nigel-daniels/ADSR-1/LM336-5.0/LM336-5.0.step

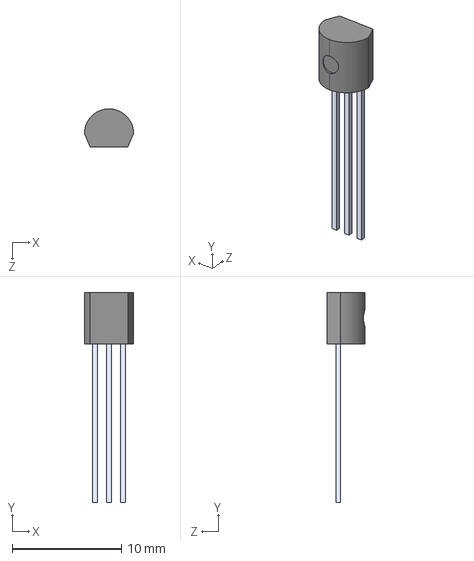
[picture p2: CAD file, 2026-11-09]
LM336-5.0/LM336-5.0.step
4.50 x 19.2 x 3.50 mm
