nigel-daniels/ADSR-1/ADSR 1.kicad_pcb

## KiCad design ADSR 1.kicad_pcb (2026-11-09)

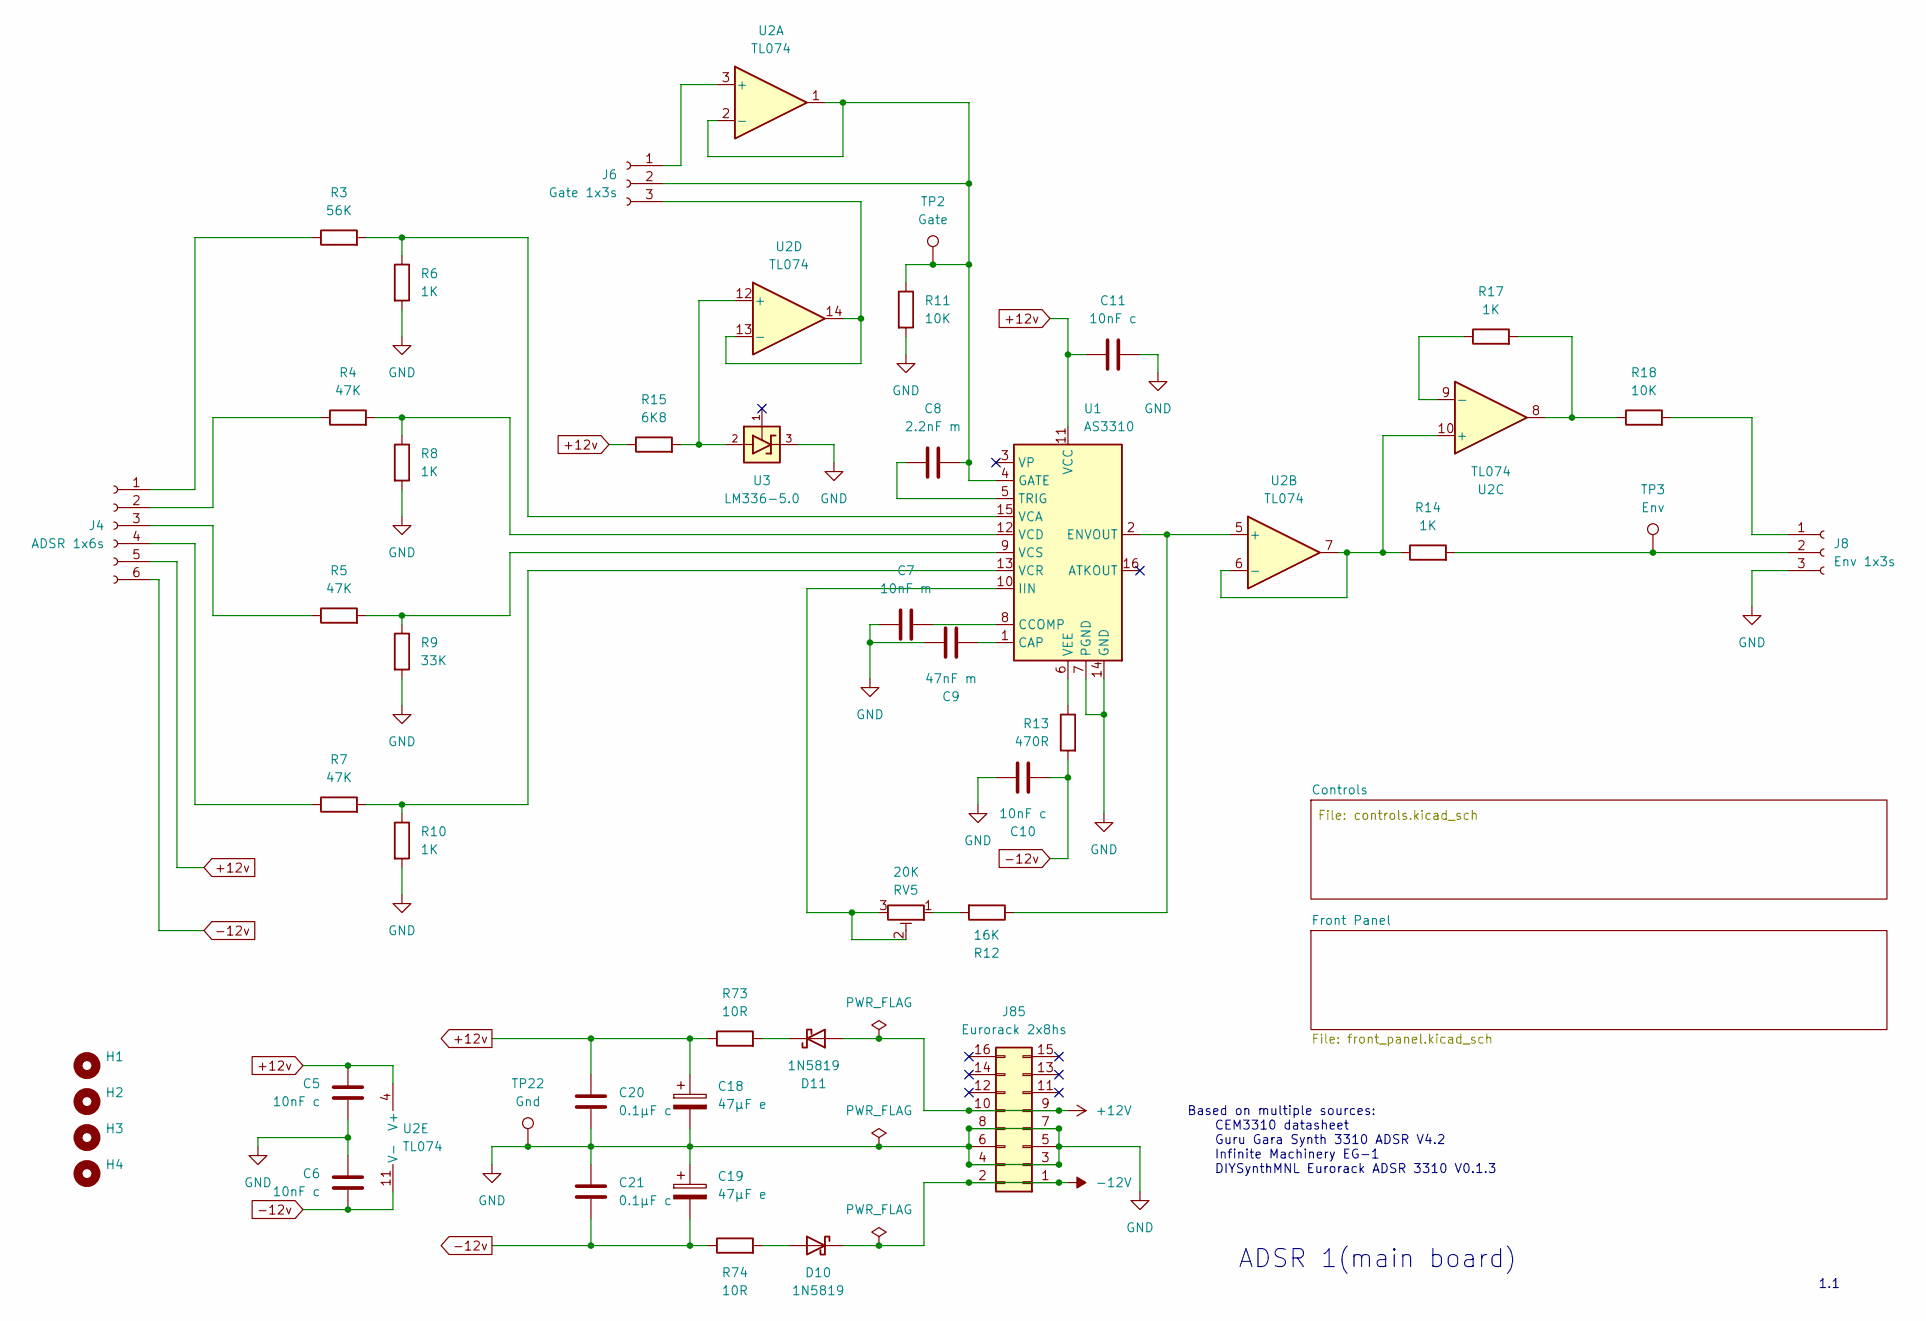
[picture p3: schematic ADSR 1.kicad_sch]

Parts:
C5, C6, C10, C11: 10nF c; C_Disc_D4.7mm_W2.5mm_P5.00mm
C7: 10nF m; C_Rect_L7.2mm_W2.5mm_P5.00mm
C8: 2.2nF m; C_Rect_L7.2mm_W2.5mm_P5.00mm
C9: 47nF m; C_Rect_L7.2mm_W2.5mm_P5.00mm
C18, C19: 47μF e; CP_Radial_D5.0mm_P2.50mm
C20, C21: 0.1μF c; C_Disc_D4.7mm_W2.5mm_P5.00mm
D10, D11: 1N5819; D_DO-41_SOD81_P10.16mm_Horizontal
H1, H2, H3, H4: MountingHole_2.7mm_M2.5
J4: ADSR 1x6s; PinSocket_1x06_P2.54mm_Vertical
J6: Gate 1x3s; PinSocket_1x03_P2.54mm_Vertical
J8: Env 1x3s; PinSocket_1x03_P2.54mm_Vertical
J85: Eurorack 2x8hs; IDC-Header_2x08_P2.54mm_Vertical
R3: 56K; R_Axial_DIN0204_L3.6mm_D1.6mm_P2.54mm_Vertical
R4, R5: 47K; R_Axial_DIN0204_L3.6mm_D1.6mm_P2.54mm_Vertical
R6, R8, R10, R17: 1K; R_Axial_DIN0204_L3.6mm_D1.6mm_P2.54mm_Vertical
R7: 47K; R_Axial_DIN0204_L3.6mm_D1.6mm_P7.62mm_Horizontal
R9: 33K; R_Axial_DIN0204_L3.6mm_D1.6mm_P2.54mm_Vertical
R11, R18: 10K; R_Axial_DIN0204_L3.6mm_D1.6mm_P7.62mm_Horizontal
R12: 16K; R_Axial_DIN0204_L3.6mm_D1.6mm_P7.62mm_Horizontal
R13: 470R; R_Axial_DIN0204_L3.6mm_D1.6mm_P7.62mm_Horizontal
R14: 1K; R_Axial_DIN0204_L3.6mm_D1.6mm_P7.62mm_Horizontal
R15: 6K8; R_Axial_DIN0204_L3.6mm_D1.6mm_P7.62mm_Horizontal
R73, R74: 10R; R_Axial_DIN0204_L3.6mm_D1.6mm_P2.54mm_Vertical
RV5: 20K; Potentiometer_Bourns_3296X_Horizontal
TP2: Gate; TestPoint_Loop_D2.50mm_Drill1.0mm
TP3: Env; TestPoint_Loop_D2.50mm_Drill1.0mm
TP22: Gnd; TestPoint_Loop_D2.50mm_Drill1.0mm
U1: AS3310; DIP-16_W7.62mm_Socket
U2: TL074; DIP-14_W7.62mm_Socket
U3: LM336-5.0; TO-92_Inline_Wide

Connections:
+12V: D11.2 (A), J85.9, J85.10
+12v: C5.2, C11.1, C18.1, C20.1, J4.5, R15.1, R73.1, U1.11 (VCC), U2.4 (V+)
-12V: D10.1 (K), J85.1, J85.2
-12v: C6.1, C10.2, C19.2, C21.2, J4.6, R13.2, R74.1, U2.11 (V-)
GND: C5.1, C6.2, C7.1, C9.1, C10.1, C11.2, C18.2, C19.1, C20.2, C21.1, J8.3, J85.3, J85.4, J85.5, J85.6, J85.7, J85.8, R6.2, R8.2, R9.2, R10.2, R11.2, TP22.1 (1_1), U1.7 (PGND), U1.14 (GND), U3.3; also elsewhere on the board
unnamed: D10.2 (A), R74.2
unnamed: D11.1 (K), R73.2
unnamed: J4.1, R3.1
unnamed: J4.2, R4.1
unnamed: J4.3, R5.1
unnamed: J4.4, R7.1
unnamed: J6.1, U2.3 (+)
unnamed: C8.2, J6.2, R11.1, TP2.1 (1_1), U1.4 (GATE), U2.1, U2.2 (-)
unnamed: J6.3, U2.13 (-), U2.14
unnamed: J8.1, R18.2
unnamed: J8.2, R14.2, TP3.1 (1_1)
unnamed: R12.2, RV5.1
unnamed: R17.2, R18.1, U2.8
unnamed: C9.2, U1.1 (CAP)
unnamed: C7.2, U1.8 (CCOMP)
unnamed: R12.1, U1.2 (ENVOUT), U2.5 (+)
unnamed: RV5.2, RV5.3, U1.10 (IIN)
unnamed: C8.1, U1.5 (TRIG)
unnamed: R3.2, R6.1, U1.15 (VCA)
unnamed: R4.2, R8.1, U1.12 (VCD)
unnamed: R7.2, R10.1, U1.13 (VCR)
unnamed: R5.2, R9.1, U1.9 (VCS)
unnamed: R13.1, U1.6 (VEE)
unnamed: R14.1, U2.6 (-), U2.7, U2.10 (+)
unnamed: R17.1, U2.9 (-)
unnamed: R15.2, U2.12 (+), U3.2

Notes on the sheet:
Based on multiple sources: CEM3310 datasheet Guru Gara Synth 3310 ADSR V4.2 Infinite Machinery EG-1 DIYSynthMNL Eurorack ADSR 3310 V0.1.3
1.1
ADSR 1(main board)

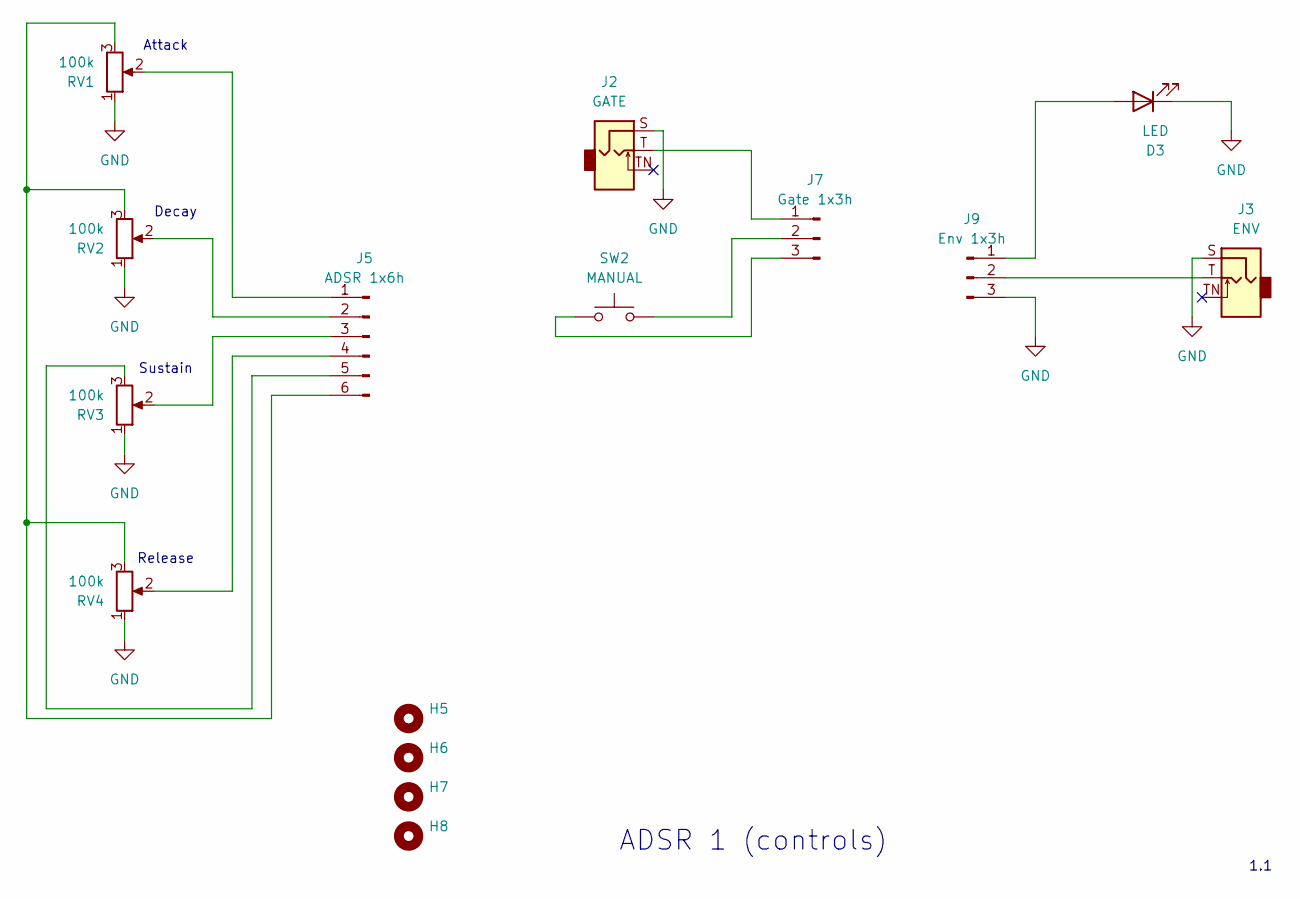
[picture p4: schematic controls.kicad_sch]

Parts:
D3: LED; LED_D3.0mm_FlatTop
H5, H6, H7, H8: MountingHole_2.7mm_M2.5
J2: GATE; Jack_3.5mm_QingPu_WQP-PJ398SM_Vertical_CircularHoles
J3: ENV; Jack_3.5mm_QingPu_WQP-PJ398SM_Vertical_CircularHoles
J5: ADSR 1x6h; PinHeader_1x06_P2.54mm_Vertical
J7: Gate 1x3h; PinHeader_1x03_P2.54mm_Vertical
J9: Env 1x3h; PinHeader_1x03_P2.54mm_Vertical
RV1, RV2, RV3, RV4: 100k; Potentiometer_Alps_RK09L_Single_Vertical
SW2: MANUAL; SW_Momentary_Push

Connections:
GND: D3.1 (K), J2.S, J3.S, J9.3, RV1.1, RV2.1, RV3.1, RV4.1; also elsewhere on the board
unnamed: D3.2 (A), J9.1
unnamed: J5.1, RV1.2
unnamed: J5.2, RV2.2
unnamed: J5.3, RV3.2
unnamed: J5.4, RV4.2
unnamed: J5.5, RV3.3
unnamed: J5.6, RV1.3, RV2.3, RV4.3
unnamed: J2.T, J7.1
unnamed: J7.2, SW2.2
unnamed: J7.3, SW2.1
unnamed: J3.T, J9.2

Notes on the sheet:
ADSR 1 (controls)
Sustain
1.1
Attack
Decay
Release

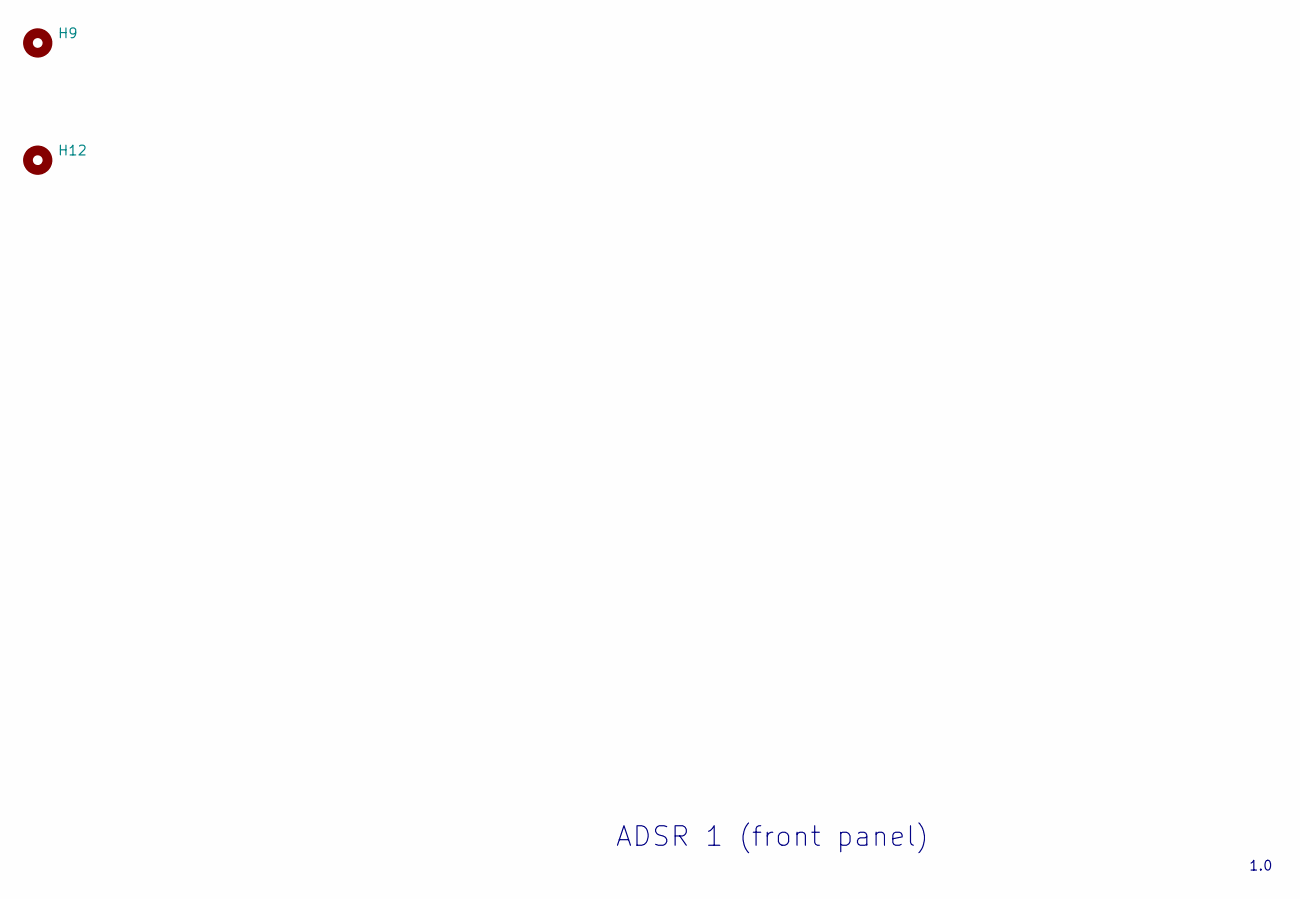
[picture p5: schematic front_panel.kicad_sch]

Parts:
H9, H12: MountingHole_3.2mm_M3

Notes on the sheet:
ADSR 1 (front panel)
1.0

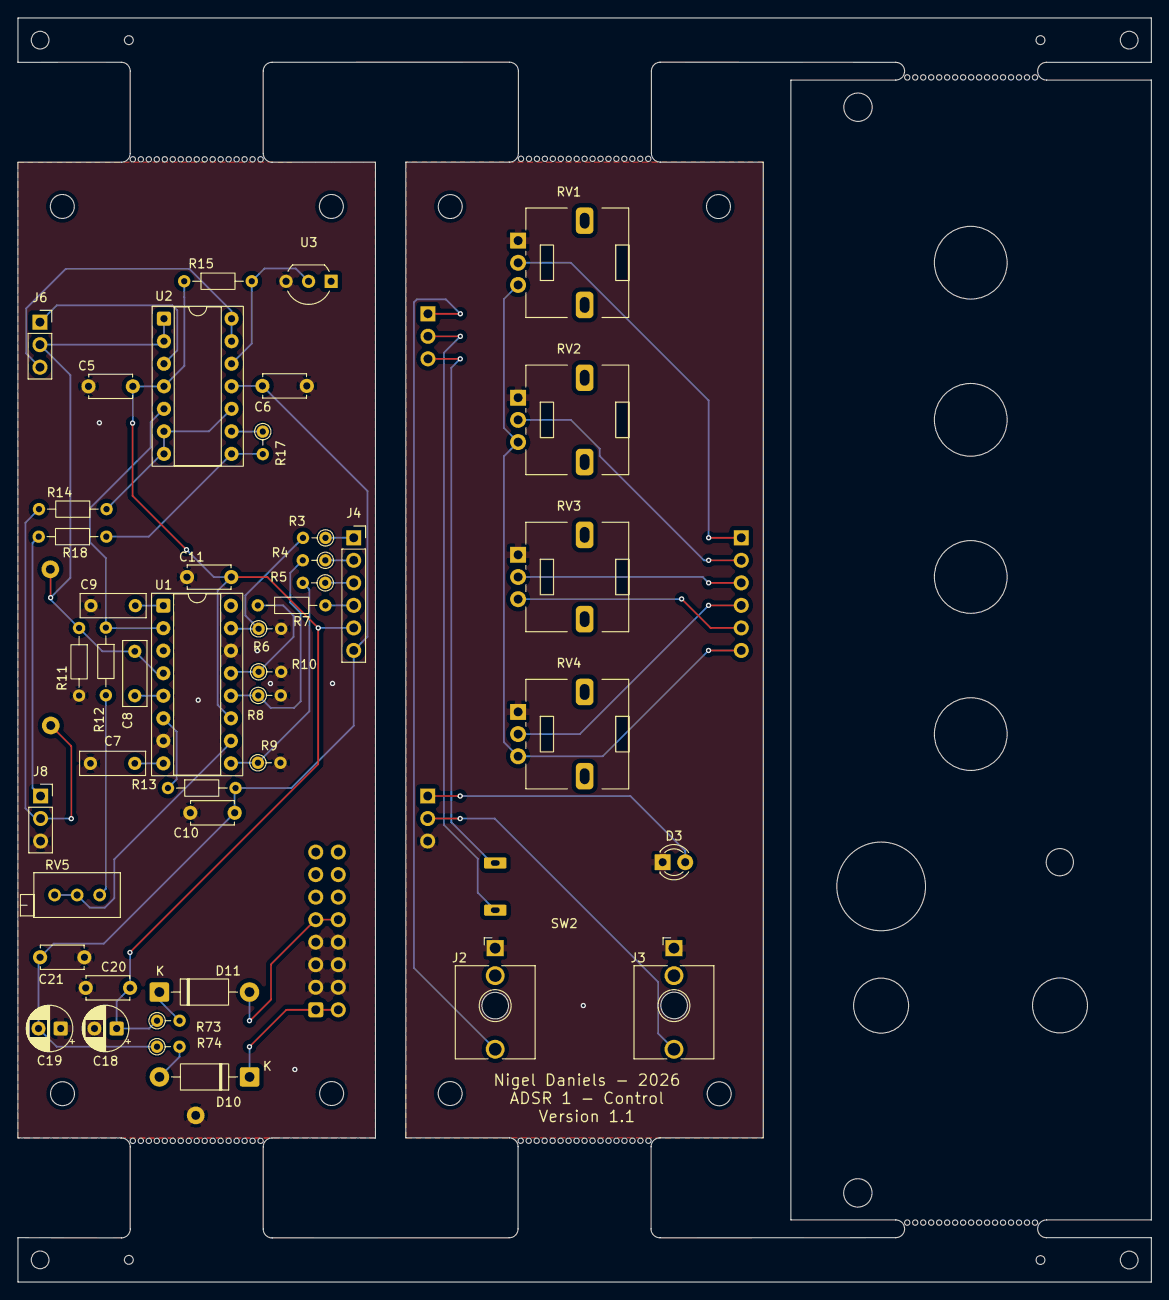
[picture p6: board ADSR 1.kicad_pcb from above]

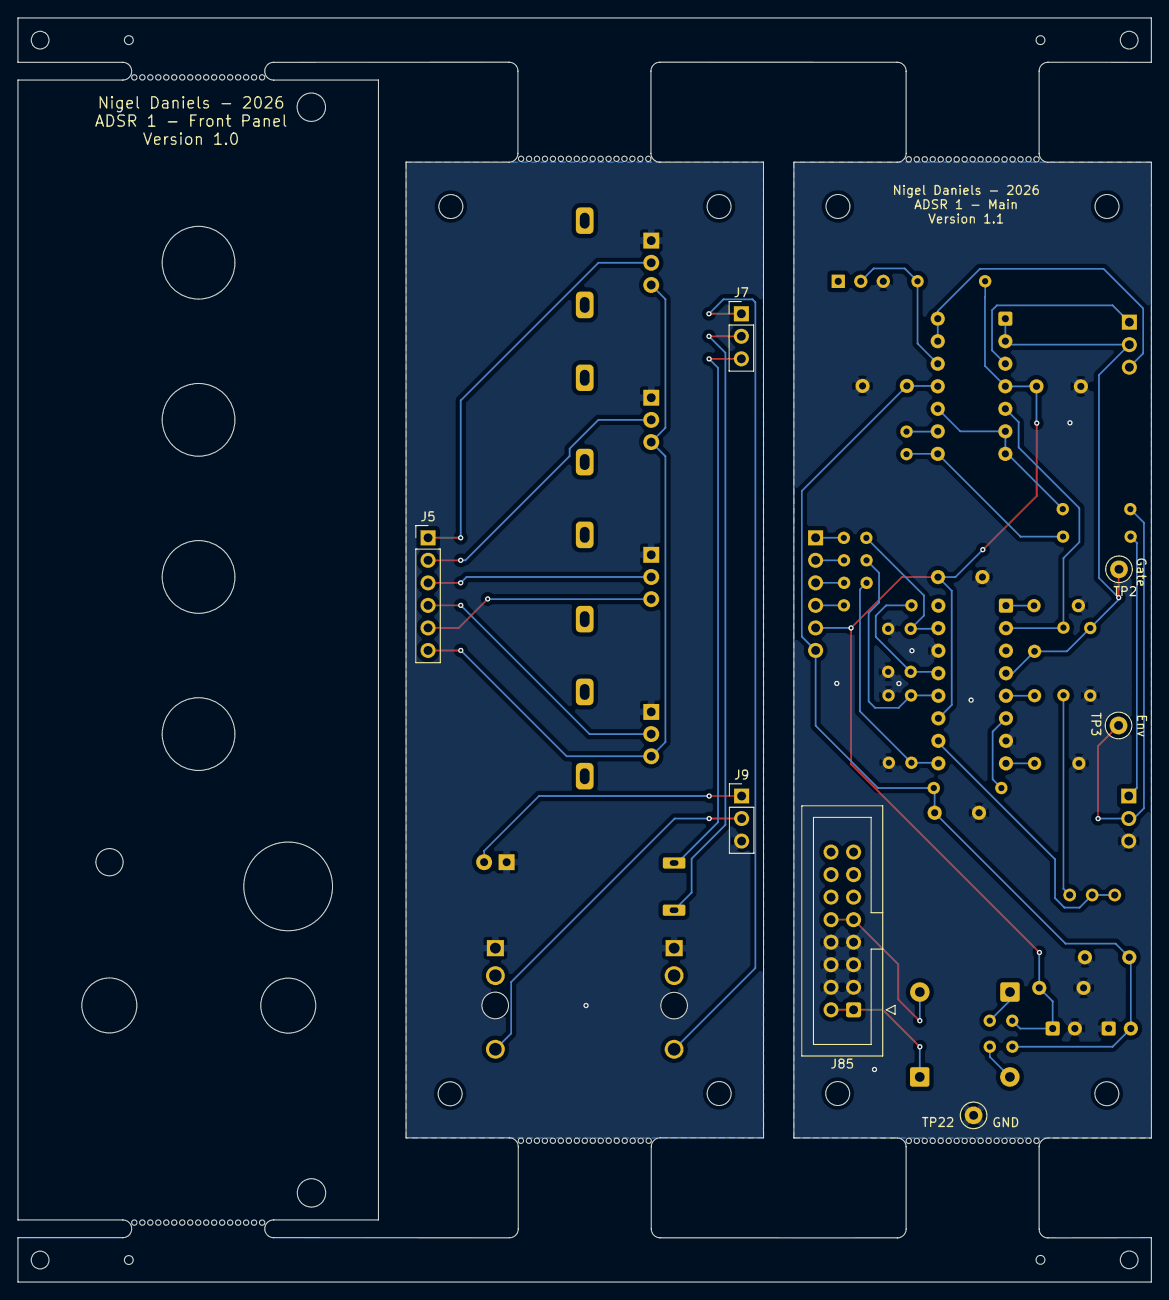
[picture p7: board ADSR 1.kicad_pcb from below]

Board: 2 copper layers, 127.8 x 142.5 mm, 62 parts (7 on the bottom side), 42 nets.
