nigel-daniels/ADSR-1/(commit log)

2026-11-09 Updated to JLCPCB version
    [ADSR 1 JLCPCB-B_Cu.gbl, ADSR 1 JLCPCB-B_Fab.gbr, ADSR 1 JLCPCB-B_Mask.gbs, ADSR 1 JLCPCB-B_Paste.gbp, ADSR 1 JLCPCB-B_Silkscreen.gbo, ADSR 1 JLCPCB-Edge_Cuts.gm1, ADSR 1 JLCPCB-F_Cu.gtl, ADSR 1 JLCPCB-F_Fab.gbr]
2026-11-09 Removed fab files and folder
    [ADSR 1 JLCPCB-B_Cu.gbl, ADSR 1 JLCPCB-B_Fab.gbr, ADSR 1 JLCPCB-B_Mask.gbs, ADSR 1 JLCPCB-B_Paste.gbp, ADSR 1 JLCPCB-B_Silkscreen.gbo, ADSR 1 JLCPCB-Edge_Cuts.gm1, ADSR 1 JLCPCB-F_Cu.gtl, ADSR 1 JLCPCB-F_Fab.gbr]
